EternityFOR/Self_Balance_Car/Self_Balance_Car_PCB_BOM.xlsx

Manufacturer Part | Comment | Footprint | Tolerance | Voltage Rated | Voltage Rating (Max) | Contact Material | Temperature Coefficient | Designator | Device | Name
2.54-1*4P母 | 2.54-1*4P母 | HDR-TH_4P-P2.54-V-F |  |  |  |  |  | H3,H4 | HDR-F_2.54_1x4P
0603WAF0000T5E | 0Ω | R0603 | ±1% |  |  |  | ±100ppm/℃ | R10,R14,R15,R32,R33 | 0603WAF0000T5E | 0Ω
0603WAF1001T5E | 1kΩ | R0603 | ±1% |  |  |  | ±100ppm/℃ | R8 | 0603WAF1001T5E | 1kΩ
0603WAF1002T5E | 10kΩ | R0603 | ±1% |  |  |  | ±100ppm/℃ | R3,R9,R11,R12,R13,R21,R22,R23,R24,R25,R26,R27,R28 | 0603WAF1002T5E | 10kΩ
0603WAF1003T5E | 100kΩ | R0603 | ±1% |  |  |  | ±100ppm/℃ | R4,R5 | 0603WAF1003T5E | 100kΩ
0603WAF1004T5E | 1MΩ | R0603 | ±1% |  |  |  | ±100ppm/℃ | R1 | 0603WAF1004T5E | 1MΩ
0603WAF3300T5E | 330Ω | R0603 | ±1% |  |  |  | ±100ppm/℃ | R19,R20 | 0603WAF3300T5E | 330Ω
0603WAF4700T5E | 470Ω | R0603 | ±1% |  |  |  | ±100ppm/℃ | R18 | 0603WAF4700T5E | 470Ω
0603WAF4701T5E | 4.7kΩ | R0603 | ±1% |  |  |  | ±100ppm/℃ | R29,R30,R31 | 0603WAF1002T5E | 4.7kΩ
0603WAF5100T5E | 510Ω | R0603 | ±1% |  |  |  | ±100ppm/℃ | R2 | 0603WAF5100T5E | 510Ω
AIC1221-33GY3TR | AIC1221-33GY3TR | SOT-223_L6.5-W3.5-P2.30-LS7.0-BR |  |  |  |  |  | U6 | AIC1221-33GY3TR | AIC1221-33GY3TR
CL10A105KB8NNNC | 1uF | C0603 | ±10% | 50V |  |  | X5R | C9,C11,C14 | CL10A105KB8NNNC | 1uF
CL10A106KP8NNNC | 10uF | C0603 | ±10% | 10V |  |  | X5R | C10,C12,C17 | CL10A106KP8NNNC | 10uF
CL10A225KO8NNNC | 2.2uF | C0603 | ±10% | 16V |  |  | X5R | C22 | CL10A225KO8NNNC | 2.2uF
CL10A475KO8NNNC | 4.7uF | C0603 | ±10% | 16V |  |  | X5R | C18,C19 | CL10A475KO8NNNC | 4.7uF
CL10B103KB8NNNC | 10nF | C0603 | ±10% | 50V |  |  | X7R | C27 | 0603B103K500NT | 10nF
CL10B104KB8NNNC | 100nF | C0603 | ±10% | 50V |  |  | X7R | C5,C6,C7,C8,C13,C15,C16,C20,C21,C23,C24,C25,C26,C28,C29 | CL10B104KB8NNNC | 100nF
CL10B222KB8NNNC | 2.2nF | C0603 | ±10% | 50V |  |  | X7R | C30 | 0603B222K500NT | 2.2nF
CL10C200JB8NNNC | 20pF | C0603 | ±5% | 50V |  |  | C0G | C1,C2,C3,C4 | CL10C200JB8NNNC | 20pF
CP2102N-A02-GQFN28R | CP2102N-A02-GQFN28R | QFN-28_L5.0-W5.0-P0.50-TL-EP3.3 |  |  |  |  |  | U5 | CP2102N-A02-GQFN28R | CP2102N-A02-GQFN28R
DS1023-2*3SF11 | DS1023-2*3SF11 | HDR-TH_6P-P2.54-V-F-R2-C3-S2.54 |  |  |  | - |  | H5 | DS1023-2*3SF11 | DS1023-2*3SF11
ESP32-S3-WROOM-1-N8R8 | ESP32-S3-WROOM-1-N8R8 | WIRELM-SMD_ESP32-S3-WROOM-1 |  |  |  |  |  | U9 | ESP32-S3-WROOM-1-N8R8 | ESP32-S3-WROOM-1-N8R8
HC-ZH1.5-6A | HC-ZH1.5-6A | CONN-TH_HC-ZH1.5-6A |  |  |  | 黄铜 |  | CN1,CN2,CN3,CN4 | HC-ZH1.5-6A | HC-ZH1.5-6A
KT-0603B | KT-0603B | LED0603-RD |  |  |  |  |  | LED1,LED4 | KT-0603B | KT-0603B
KT-0603R | KT-0603R | LED0603-RD |  |  |  |  |  | LED2,LED3 | KT-0603R | KT-0603R
L8050QLT1G | L8050QLT1G | SOT-23-3_L2.9-W1.3-P1.90-LS2.4-BR |  |  |  |  |  | Q1,Q2 | L8050QLT1G | L8050QLT1G
L9110S | L9110S | SOP-8_L6.1-W3.9-P1.27-LS6.0-BL-1 |  |  |  |  |  | U1,U2,U3,U4 | L9110S_C725793 | L9110S
LESD5D5.0CT1G | LESD5D5.0CT1G | SOD-523_L1.2-W0.8-LS1.6-BI |  |  |  |  |  | D2,D3,D4 | LESD5D5.0CT1G | LESD5D5.0CT1G
MPU-6050 | MPU-6050 | QFN-24_L4.0-W4.0-P0.50-BL-EP2.7 |  |  |  |  |  | U7 | MPU-6050 | MPU-6050
MTP125-1105S1 | MTP125-1105S1 | HDR-TH_5P-P2.54-V-M |  |  | 1kV | 黄铜 |  | H1,H6,H7,H8 | HDR-M_2.54_1x5P
Q13FC13500004 | 32.768kHz | FC-135R_L3.2-W1.5 |  |  |  |  |  | X1 | Q13FC13500004_C32346 | 32.768kHz
RTT032212FTP | 22.1kΩ | R0603 | ±1% |  |  |  | ±100ppm/℃ | R6 | RTT032212FTP | 22.1kΩ
RTT034752FTP | 47.5kΩ | R0603 | ±1% |  |  |  | ±100ppm/℃ | R7 | RTT034752FTP | 47.5kΩ
SS54 | SS54 | SMA_L4.4-W2.8-LS5.4-R-RD |  |  |  |  |  | D1 | SS54_C22452 | SS54
STM32F103RET6 | STM32F103RET6 | LQFP-64_L10.0-W10.0-P0.50-LS12.0-BL |  |  |  |  |  | U8 | STM32F103RET6 | STM32F103RET6
U262-161N-4BVC11 | U262-161N-4BVC11 | USB-3.1-SMD_U262-161N-4BVC11 |  |  |  | 铜合金 |  | USB1 | U262-161N-4BVC11 | U262-161N-4BVC11
X50328MSB2GI | 8MHz | CRYSTAL-SMD_L5.0-W3.2 |  |  |  |  |  | X2 | X50328MSB2GI | 8MHz
ZX-PZ2.54-2-3PZZ | ZX-PZ2.54-2-3PZZ | HDR-TH_6P-P2.54-V-M-R2-C3-S2.54-1 |  |  | 1kV | 黄铜 |  | H2 | ZX-PZ2.54-2-3PZZ | ZX-PZ2.54-2-3PZZ
ZX-QC34-2TPDZ | ZX-QC34-2TPDZ | KEY-SMD_L3.9-W3.0-LS5.0-EH |  |  |  |  |  | BOOT,RST1,RST2 | ZX-QC34-2TPDZ | ZX-QC34-2TPDZ
