EternityFOR/Self_Balance_Car/Self_Balance_Car_3D_Model/Bottom_Mount.SLDPRT

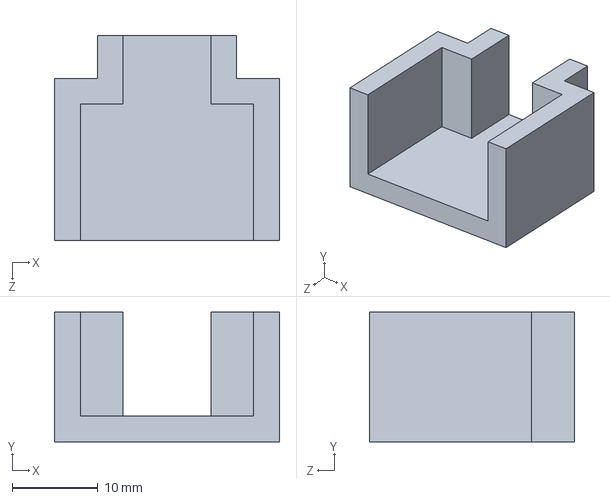
[picture p9: CAD file, 2024-07-28]
Self_Balance_Car_3D_Model/Bottom_Mount.SLDPRT
26.2 x 15.1 x 23.9 mm
