EternityFOR/Self_Balance_Car/Self_Balance_Car_3D_Model/Print/Wheel_NEW2.3mf

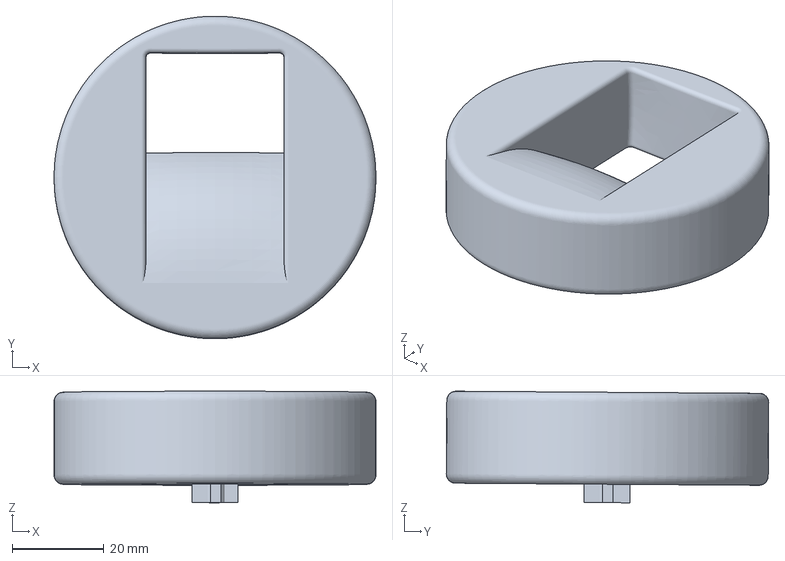
[picture p10: CAD file, 2024-07-28]
Self_Balance_Car_3D_Model/Print/Wheel_NEW2.3mf
70.0 x 70.1 x 24.3 mm
