EternityFOR/Self_Balance_Car/Self_Balance_Car_3D_Model/Body.SLDPRT

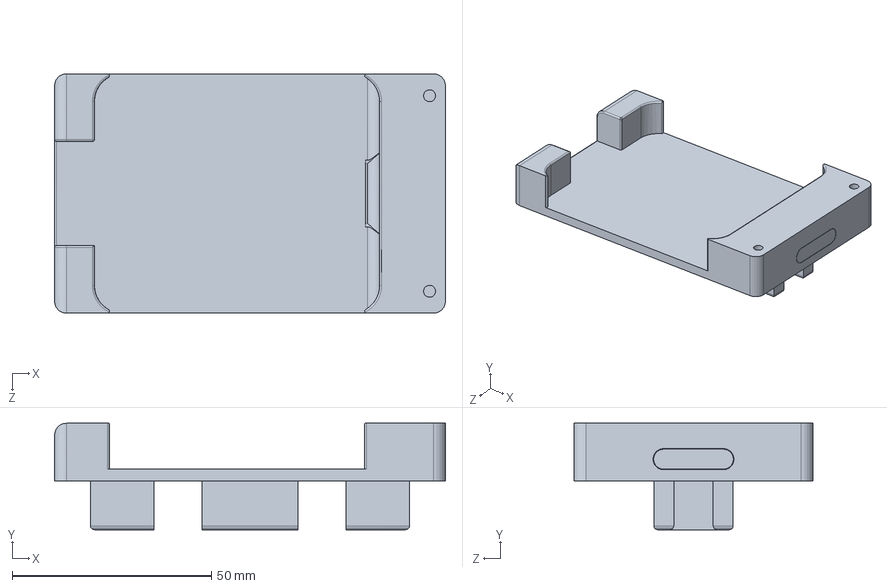
[picture p11: CAD file, 2024-07-23]
Self_Balance_Car_3D_Model/Body.SLDPRT
98.0 x 26.7 x 60.0 mm
