EternityFOR/Self_Balance_Car/Self_Balance_Car_3D_Model/Motor_mount2.SLDPRT

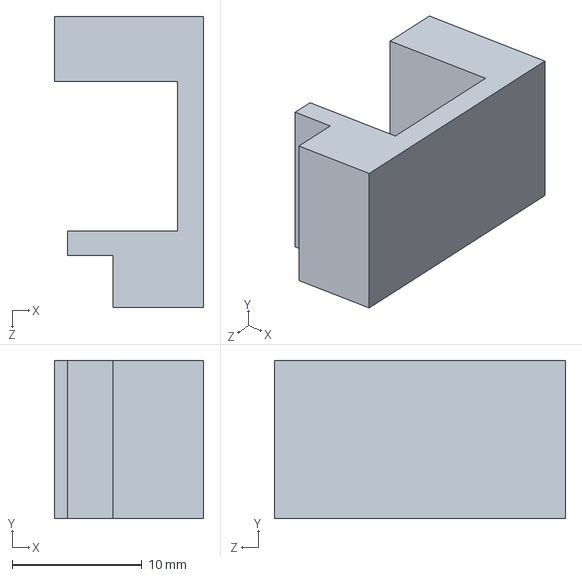
[picture p12: CAD file, 2024-07-19]
Self_Balance_Car_3D_Model/Motor_mount2.SLDPRT
11.5 x 12.2 x 22.4 mm
