EternityFOR/Self_Balance_Car/Self_Balance_Car_3D_Model/Print/WheelR.STL

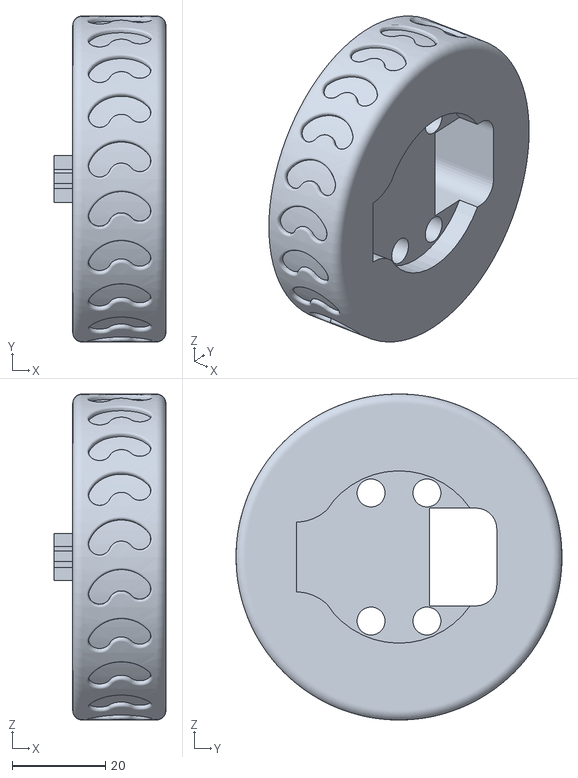
[picture p13: CAD file, 2024-07-19]
Self_Balance_Car_3D_Model/Print/WheelR.STL
24.0 x 70.0 x 70.0
