EternityFOR/Self_Balance_Car/Self_Balance_Car_3D_Model/Motor_Axle.SLDPRT

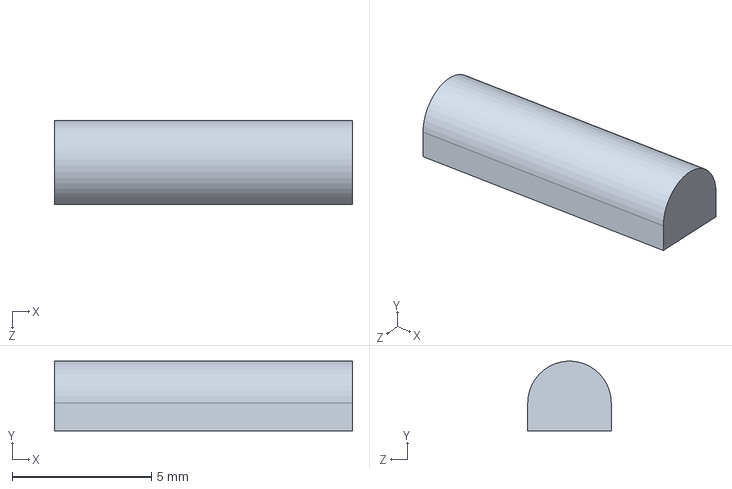
[picture p14: CAD file, 2024-07-19]
Self_Balance_Car_3D_Model/Motor_Axle.SLDPRT
10.7 x 2.50 x 3.00 mm
