EternityFOR/Self_Balance_Car/Self_Balance_Car_3D_Model/Print/Wheel_Big_New.STL

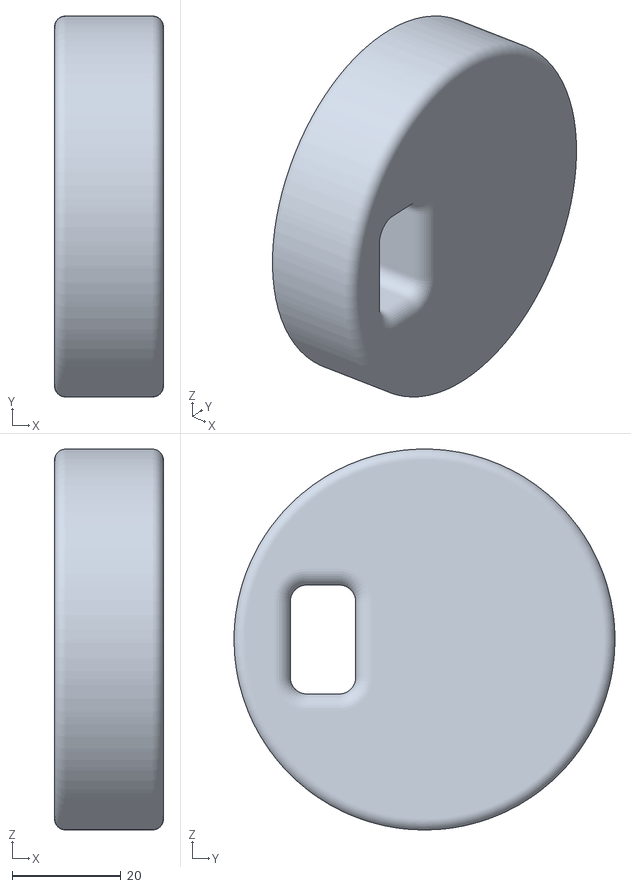
[picture p15: CAD file, 2024-07-19]
Self_Balance_Car_3D_Model/Print/Wheel_Big_New.STL
20.0 x 70.0 x 70.0
