EternityFOR/Self_Balance_Car/Self_Balance_Car_3D_Model/Motor.SLDPRT

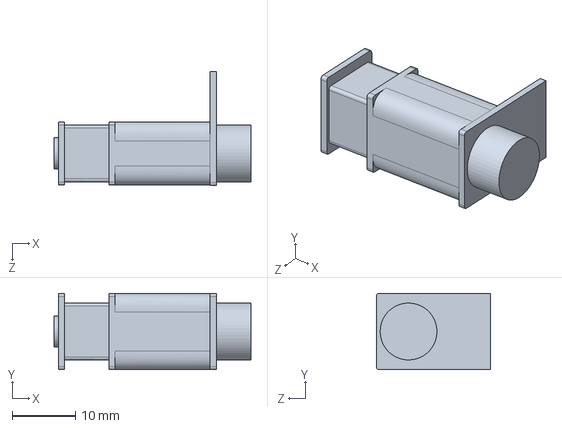
[picture p16: CAD file, 2024-07-19]
Self_Balance_Car_3D_Model/Motor.SLDPRT
31.2 x 12.1 x 18.1 mm
