EternityFOR/Self_Balance_Car/Self_Balance_Car_3D_Model/Print/Small.3mf

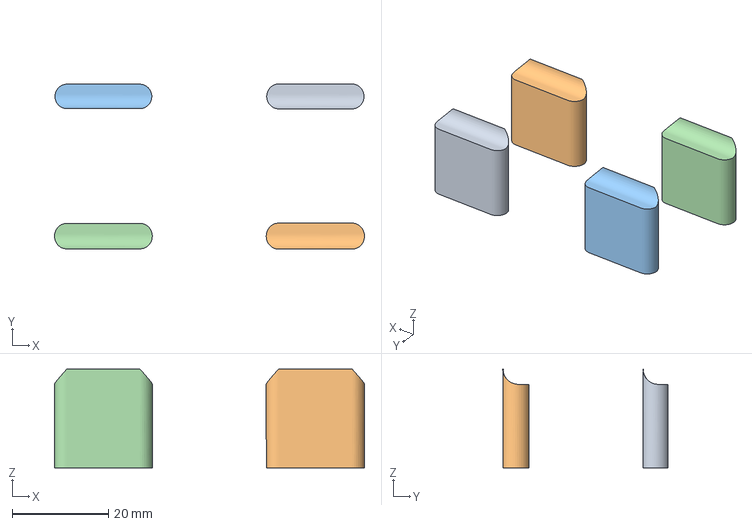
[picture p17: CAD file, 2024-07-19]
Self_Balance_Car_3D_Model/Print/Small.3mf
64.3 x 34.3 x 20.5 mm
Small.STL x 4
