EternityFOR/Self_Balance_Car/Self_Balance_Car_3D_Model/Power_Bank.SLDPRT

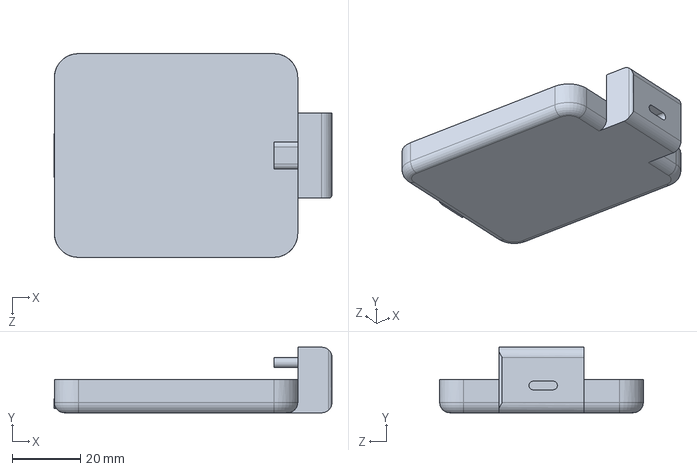
[picture p18: CAD file, 2024-07-19]
Self_Balance_Car_3D_Model/Power_Bank.SLDPRT
81.3 x 19.2 x 59.6 mm
