EternityFOR/Self_Balance_Car/Self_Balance_Car_3D_Model/Print/Middle_plate_up.STL

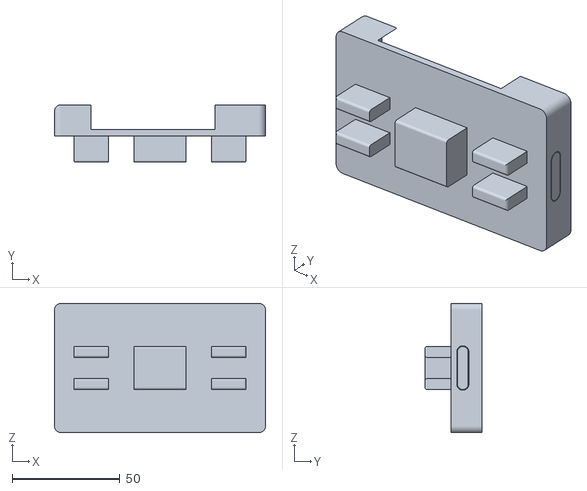
[picture p19: CAD file, 2024-07-19]
Self_Balance_Car_3D_Model/Print/Middle_plate_up.STL
98.0 x 26.7 x 60.0
