EternityFOR/Self_Balance_Car/Self_Balance_Car_3D_Model/Print/Right_Wheel_big.STL

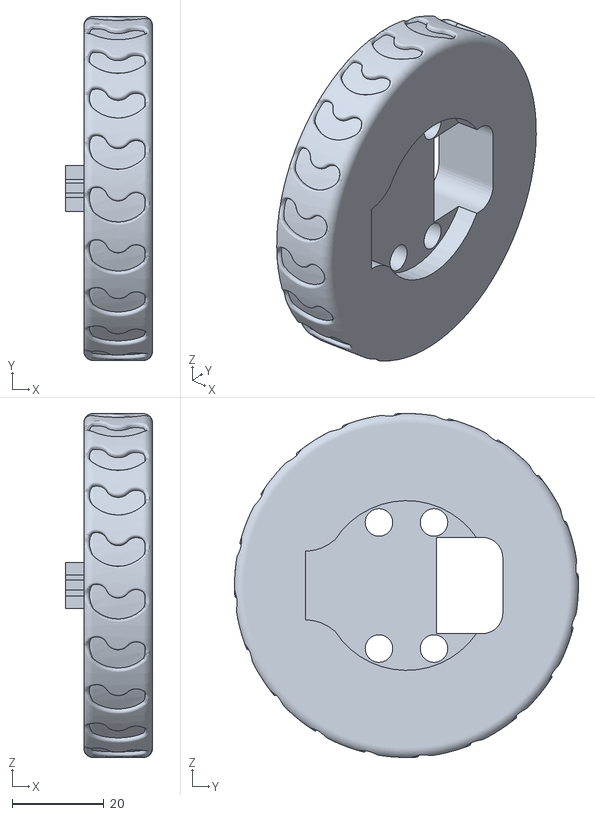
[picture p20: CAD file, 2024-07-19]
Self_Balance_Car_3D_Model/Print/Right_Wheel_big.STL
19.0 x 75.0 x 75.0
