EternityFOR/Self_Balance_Car/Self_Balance_Car_3D_Model/Print/Top_Cover.STL

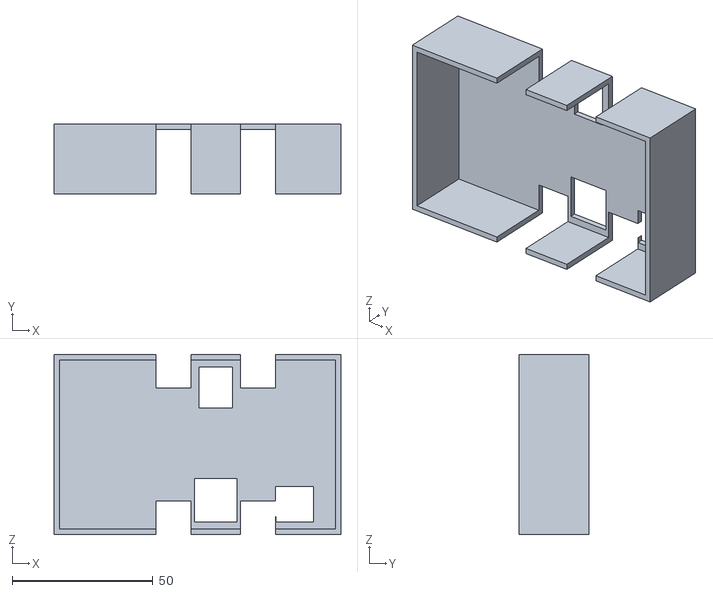
[picture p21: CAD file, 2024-07-19]
Self_Balance_Car_3D_Model/Print/Top_Cover.STL
102.0 x 25.0 x 64.0
