EternityFOR/Self_Balance_Car/Self_Balance_Car_3D_Model/Print/Bottom_Mount^Assem1.STL

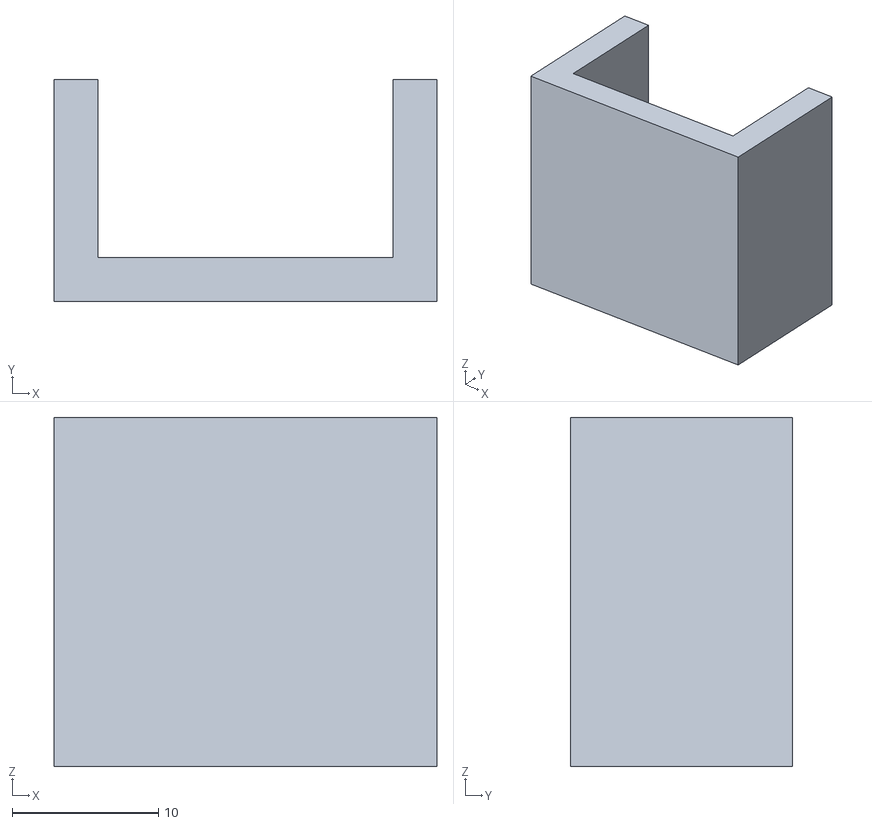
[picture p22: CAD file, 2024-07-19]
Self_Balance_Car_3D_Model/Print/Bottom_Mount^Assem1.STL
26.2 x 15.2 x 23.9
