EternityFOR/Self_Balance_Car/(list of files, cad)

Other CAD files:
Self_Balance_Car_3D_Model/Print/Wheel_NEW1.3mf
Self_Balance_Car_3D_Model/Print/Right_NEW.STL
Self_Balance_Car_3D_Model/Wheel.SLDPRT
Self_Balance_Car_3D_Model/Print/Left_NEW.STL
Self_Balance_Car_3D_Model/Middle_body.SLDPRT
Self_Balance_Car_3D_Model/Print/Wheel_Big_New2.STL
Self_Balance_Car_3D_Model/Print/WheelL.STL
Self_Balance_Car_3D_Model/Print/Left_Wheel_big.STL
Self_Balance_Car_3D_Model/Print/Body.3mf
Self_Balance_Car_3D_Model/Print/Body.STL
Self_Balance_Car_3D_Model/Print/Bottom_Mount.STL
Self_Balance_Car_3D_Model/Print/Motor_mount2.STL
Self_Balance_Car_3D_Model/Print/Small.STL
Self_Balance_Car_3D_Model/Print/Wheel_NEW1.STL
Self_Balance_Car_3D_Model/backup/Bread_Board.SLDPRT
Self_Balance_Car_3D_Model/backup/Middle_body.SLDPRT
Self_Balance_Car_3D_Model/backup/Middle_bread_board_down.SLDPRT
Self_Balance_Car_3D_Model/backup/Motor_backup.SLDPRT
Self_Balance_Car_3D_Model/backup/Motor_mount.SLDPRT
Self_Balance_Car_3D_Model/backup/Motor_mount2(1).SLDPRT
Self_Balance_Car_3D_Model/backup/Right_Wheel.SLDPRT
Self_Balance_Car_3D_Model/backup/Right_Wheel_big.SLDPRT
Self_Balance_Car_3D_Model/backup/Speaker.SLDPRT
Self_Balance_Car_3D_Model/backup/Wheel.SLDPRT
