EternityFOR/Self_Balance_Car/Self_Balance_Car_STM32F103RET6/Core/Src/main.c

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
/* Includes ------------------------------------------------------------------*/
#include "main.h"
#include "cmsis_os.h"

/* USER CODE BEGIN Includes */
#include <stdio.h>
#include <string.h>
#include <math.h>
#include "stm32f1xx_hal_flash.h"
//Gyro
#include "Gyro.h"
//Motor
#include "Motor.h"
//Encoder
#include "Encoder.h"

/* USER CODE END Includes */

DAC_HandleTypeDef hdac;

I2C_HandleTypeDef hi2c1;
I2C_HandleTypeDef hi2c2;

SPI_HandleTypeDef hspi2;

TIM_HandleTypeDef htim1;
TIM_HandleTypeDef htim2;
TIM_HandleTypeDef htim3;
TIM_HandleTypeDef htim4;
TIM_HandleTypeDef htim5;
TIM_HandleTypeDef htim8;

UART_HandleTypeDef huart2;
DMA_HandleTypeDef hdma_usart2_rx;
DMA_HandleTypeDef hdma_usart2_tx;

/* Definitions for msg_rx_t */
osThreadId_t msg_rx_tHandle;
const osThreadAttr_t msg_rx_t_attributes = {
  .name = "msg_rx_t",
  .stack_size = 512 * 4,
  .priority = (osPriority_t) osPriorityNormal,
};
/* Definitions for Motor_update_t */
osThreadId_t Motor_update_tHandle;
const osThreadAttr_t Motor_update_t_attributes = {
  .name = "Motor_update_t",
  .stack_size = 128 * 4,
  .priority = (osPriority_t) osPriorityNormal,
};
/* Definitions for msg_rx_q */
osMessageQueueId_t msg_rx_qHandle;
const osMessageQueueAttr_t msg_rx_q_attributes = {
  .name = "msg_rx_q"
};
/* USER CODE BEGIN PV */
//Car_ctr&setup_data
#define FLASH_PID_PARAMS_ADDRESS 0x0800ff00
#define RX_BUFFER_SIZE_1 150
uint8_t rxBuffer_1[RX_BUFFER_SIZE_1];
uint8_t rxIndex_1 = 0;
uint8_t rxData_1;
//#define RX_BUFFER_SIZE_2 64
//uint8_t rxBuffer_2[RX_BUFFER_SIZE_2];
//uint8_t rxIndex_2 = 0;
//uint8_t rxData_2;
typedef enum {
    DataType_Control,
    DataType_Weather,
    DataType_PID,
    DataType_Mode_Control,
    DataType_Unknown // Useful for error handling
} DataType;
typedef struct {
    DataType type;
    uint8_t msg_Data[RX_BUFFER_SIZE_1];
    int L; // Left wheel speed
    int R; // Right wheel speed
    int A; // Additional action or mode

    struct {
        float Balance_Kp, Balance_Ki, Balance_Kd; // Balance PID
        float Velocity_Kp, Velocity_Ki, Velocity_Kd; // Velocity PID
    } PID;

    struct {
        char weather[32]; // Description of the weather
        int temperature; // Temperature
        char date[16]; // Date in YYYY-MM-DD format
        char time[16]; // Time HH:MM format
    } WeatherData;
} msg_data_t;
MotorControl motor_R, motor_L;
float Balance_Kp, Balance_Ki, Balance_Kd;
float Velocity_Kp, Velocity_Ki, Velocity_Kd;
#define DEFAULT_BALANCE_KP 263.0f
#define DEFAULT_BALANCE_KI 0.0f
#define DEFAULT_BALANCE_KD 0.4f
#define DEFAULT_VELOCITY_KP 0.6f
#define DEFAULT_VELOCITY_KI 0.0025f
#define DEFAULT_VELOCITY_KD 0.0f
uint8_t ctr_cmd;
/* USER CODE END PV */

void SystemClock_Config(void);
static void MX_GPIO_Init(void);
static void MX_DMA_Init(void);
static void MX_TIM1_Init(void);
static void MX_TIM2_Init(void);
static void MX_TIM3_Init(void);
static void MX_TIM4_Init(void);
static void MX_TIM8_Init(void);
static void MX_I2C2_Init(void);
static void MX_TIM5_Init(void);
static void MX_USART2_UART_Init(void);
static void MX_DAC_Init(void);
static void MX_I2C1_Init(void);
static void MX_SPI2_Init(void);
void msg_rx(void *argument);
void Motor_update(void *argument);

/* USER CODE BEGIN PFP */
int _write(int file , char *ptr,int len)
{
    int i = 0;
    for(i = 0;i<len;i++)
        ITM_SendChar((*ptr++));
    return len;
}
/* USER CODE END PFP */

/* USER CODE BEGIN 0 */
void Timer_Start(void)
{
// ***** CN2 CN4 *****
	HAL_TIM_PWM_Start(&htim1, TIM_CHANNEL_1);
	HAL_TIM_PWM_Start(&htim1, TIM_CHANNEL_2);
	HAL_TIM_PWM_Start(&htim8, TIM_CHANNEL_1);
	HAL_TIM_PWM_Start(&htim8, TIM_CHANNEL_2);
	HAL_TIM_Encoder_Start(&htim3, TIM_CHANNEL_1);
	HAL_TIM_Encoder_Start(&htim3, TIM_CHANNEL_2);
	HAL_TIM_Encoder_Start(&htim5, TIM_CHANNEL_1);
	HAL_TIM_Encoder_Start(&htim5, TIM_CHANNEL_2);

// ***** CN1 CN3 *****
//	  HAL_TIM_PWM_Start(&htim1, TIM_CHANNEL_3);
//	  HAL_TIM_PWM_Start(&htim1, TIM_CHANNEL_4);
//	  HAL_TIM_PWM_Start(&htim8, TIM_CHANNEL_3);
//	  HAL_TIM_PWM_Start(&htim8, TIM_CHANNEL_4);
//	  HAL_TIM_Encoder_Start(&htim2, TIM_CHANNEL_1);
//	  HAL_TIM_Encoder_Start(&htim2, TIM_CHANNEL_2);
//	  HAL_TIM_Encoder_Start(&htim4, TIM_CHANNEL_1);
//	  HAL_TIM_Encoder_Start(&htim4, TIM_CHANNEL_2);
}
int is_nan(float value) {
    // Check standard isnan
    if (isnan(value)) return 1;

    // Additional check for NaN representation using union
    union {
        float f;
        uint32_t u;
    } converter;

    converter.f = value;
    return (converter.u & 0x7fffffff) > 0x7f800000;
}
/* USER CODE END 0 */

/**
  * @brief  The application entry point.
  * @retval int
  */
int main(void)
{

  /* MCU Configuration--------------------------------------------------------*/

  /* Reset of all peripherals, Initializes the Flash interface and the Systick. */
  HAL_Init();

  /* Configure the system clock */
  SystemClock_Config();

  /* Initialize all configured peripherals */
  MX_GPIO_Init();
  MX_DMA_Init();
  MX_TIM1_Init();
  MX_TIM2_Init();
  MX_TIM3_Init();
  MX_TIM4_Init();
  MX_TIM8_Init();
  MX_I2C2_Init();
  MX_TIM5_Init();
  MX_USART2_UART_Init();
  MX_DAC_Init();
  MX_I2C1_Init();
  MX_SPI2_Init();
  /* USER CODE BEGIN 2 */
  BSP_MPU6050_Init();
  Timer_Start();
  ReadPIDParamsFromFlash(&Balance_Kp, &Balance_Ki, &Balance_Kd, &Velocity_Kp, &Velocity_Ki, &Velocity_Kd);

// ***** CN2 CN4 *****
  initMotorControl(&motor_R, TIM_CHANNEL_1, TIM_CHANNEL_2, GetEncoder_Counter_R);
  initMotorControl(&motor_L, TIM_CHANNEL_1, TIM_CHANNEL_2, GetEncoder_Counter_L);

// ***** CN1 CN3 *****
//  initMotorControl(&motor_R, TIM_CHANNEL_3, TIM_CHANNEL_4, GetEncoder_Counter_R);
//  initMotorControl(&motor_L, TIM_CHANNEL_3, TIM_CHANNEL_4, GetEncoder_Counter_L);
  /* USER CODE END 2 */

  /* Init scheduler */
  osKernelInitialize();

  /* USER CODE BEGIN RTOS_MUTEX */
  /* add mutexes, ... */
  /* USER CODE END RTOS_MUTEX */

  /* USER CODE BEGIN RTOS_SEMAPHORES */
  /* add semaphores, ... */
  /* USER CODE END RTOS_SEMAPHORES */

  /* USER CODE BEGIN RTOS_TIMERS */
  /* start timers, add new ones, ... */
  /* USER CODE END RTOS_TIMERS */

  /* Create the queue(s) */
  /* creation of msg_rx_q */
  msg_rx_qHandle = osMessageQueueNew (10, sizeof(msg_data_t), &msg_rx_q_attributes);

  /* USER CODE BEGIN RTOS_QUEUES */
  /* add queues, ... */
  /* USER CODE END RTOS_QUEUES */

  /* Create the thread(s) */
  /* creation of msg_rx_t */
  msg_rx_tHandle = osThreadNew(msg_rx, NULL, &msg_rx_t_attributes);

  /* creation of Motor_update_t */
  Motor_update_tHandle = osThreadNew(Motor_update, NULL, &Motor_update_t_attributes);

  /* USER CODE BEGIN RTOS_THREADS */
  /* add threads, ... */
  /* USER CODE END RTOS_THREADS */

  /* USER CODE BEGIN RTOS_EVENTS */
  /* add events, ... */
  /* USER CODE END RTOS_EVENTS */

  /* Start scheduler */
  osKernelStart();

  /* We should never get here as control is now taken by the scheduler */

  /* Infinite loop */
  /* USER CODE BEGIN WHILE */

  while (1)
  {
    /* USER CODE END WHILE */

    /* USER CODE BEGIN 3 */
  }
  /* USER CODE END 3 */
}

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
/* USER CODE BEGIN 4 */
//Uart Callback

HAL_StatusTypeDef WritePIDParamsToFlash(float Balance_Kp, float Balance_Ki, float Balance_Kd, float Velocity_Kp, float Velocity_Ki, float Velocity_Kd) {
    HAL_StatusTypeDef status;
    uint32_t data[6];
    uint32_t address = FLASH_PID_PARAMS_ADDRESS;

    memcpy(&data[0], &Balance_Kp, sizeof(float));
    memcpy(&data[1], &Balance_Ki, sizeof(float));
    memcpy(&data[2], &Balance_Kd, sizeof(float));
    memcpy(&data[3], &Velocity_Kp, sizeof(float));
    memcpy(&data[4], &Velocity_Ki, sizeof(float));
    memcpy(&data[5], &Velocity_Kd, sizeof(float));

    //FLASH_Unlock
    HAL_FLASH_Unlock();

    FLASH_EraseInitTypeDef eraseInitStruct;
    uint32_t SectorError;
    eraseInitStruct.TypeErase = FLASH_TYPEERASE_PAGES;
    eraseInitStruct.PageAddress = FLASH_PID_PARAMS_ADDRESS;
    eraseInitStruct.NbPages = 1;
    status = HAL_FLASHEx_Erase(&eraseInitStruct, &SectorError);
    if (status != HAL_OK) {
        HAL_FLASH_Lock();
        return status;
    }

    /* Write the PID parameters to flash, word by word (32 bits) */
    for (uint32_t i = 0; i < (sizeof(data) / sizeof(uint32_t)); i++) {
        status = HAL_FLASH_Program(FLASH_TYPEPROGRAM_WORD, address, data[i]);
        if (status != HAL_OK) {
            break;
        }
        address += 4;
    }
    //FLASH_Lock
    HAL_FLASH_Lock();

    return status;
}

void ReadPIDParamsFromFlash(float *Balance_Kp, float *Balance_Ki, float *Balance_Kd, float *Velocity_Kp, float *Velocity_Ki, float *Velocity_Kd) {
    memcpy(Balance_Kp, (float*)FLASH_PID_PARAMS_ADDRESS, sizeof(float));
    memcpy(Balance_Ki, (float*)(FLASH_PID_PARAMS_ADDRESS + 4), sizeof(float));
    memcpy(Balance_Kd, (float*)(FLASH_PID_PARAMS_ADDRESS + 8), sizeof(float));
    memcpy(Velocity_Kp, (float*)(FLASH_PID_PARAMS_ADDRESS + 12), sizeof(float));
    memcpy(Velocity_Ki, (float*)(FLASH_PID_PARAMS_ADDRESS + 16), sizeof(float));
    memcpy(Velocity_Kd, (float*)(FLASH_PID_PARAMS_ADDRESS + 20), sizeof(float));

    // Check for NaN values and set to default if necessary
    if (is_nan(*Balance_Kp)) *Balance_Kp = DEFAULT_BALANCE_KP;
    if (is_nan(*Balance_Ki)) *Balance_Ki = DEFAULT_BALANCE_KI;
    if (is_nan(*Balance_Kd)) *Balance_Kd = DEFAULT_BALANCE_KD;
    if (is_nan(*Velocity_Kp)) *Velocity_Kp = DEFAULT_VELOCITY_KP;
    if (is_nan(*Velocity_Ki)) *Velocity_Ki = DEFAULT_VELOCITY_KI;
    if (is_nan(*Velocity_Kd)) *Velocity_Kd = DEFAULT_VELOCITY_KD;
}

void UART_IRQHandler_IDLE(UART_HandleTypeDef *huart)
{
	msg_data_t ctr;
	if(huart == &huart2)
	{
		if(__HAL_UART_GET_FLAG(huart, UART_FLAG_IDLE) != RESET)
		{
			HAL_UART_DMAStop(&huart2);
			__HAL_UART_CLEAR_IDLEFLAG(&huart2);
			__HAL_UART_CLEAR_OREFLAG(&huart2);
			memcpy(ctr.msg_Data ,rxBuffer_1, sizeof(rxBuffer_1));
			osStatus_t status = osMessageQueuePut(msg_rx_qHandle, &ctr, 0, 0);
			if (status != osOK) {printf("Failed to put message into queue\n");}
			HAL_UART_Receive_DMA(&huart2, rxBuffer_1, sizeof(rxBuffer_1));
		}
	}
}

/* USER CODE END 4 */

/* USER CODE BEGIN Header_msg_rx */
/**
  * @brief  Function implementing the msg_rx_t thread.
  * @param  argument: Not used
  * @retval None
  */
/* USER CODE END Header_msg_rx */
void msg_rx(void *argument)
{
  /* USER CODE BEGIN 5 */
	msg_data_t ctr;
	char type[32];
	for(;;) {
		if (osMessageQueueGet(msg_rx_qHandle, &ctr, NULL, osWaitForever) == osOK) {
			printf("%s\n",ctr.msg_Data);
			if (sscanf((char*)ctr.msg_Data, "{\"Type\":\"%[^\"]\"", type) == 1) {
				if (strcmp(type, "Control") == 0) {
					if (sscanf((char*)ctr.msg_Data, "{\"Type\":\"Control\",\"L\":%d,\"R\":%d,\"A\":%d}",
							   &ctr.L, &ctr.R, &ctr.A) == 3) {
						motor_R.targetSpeed = ctr.R;
						motor_L.targetSpeed = ctr.L;
						ctr_cmd = ctr.A;
						ctr.type = DataType_Control;
					}
				}
				else if (strcmp(type, "Weather") == 0) {
					if (sscanf((char*)ctr.msg_Data, "{\"Type\":\"Weather\",\"Weather\":\"%[^\"]\",\"Temperature\":%d,\"Date\":\"%[^\"]\",\"Time\":\"%[^\"]\"}",
							   ctr.WeatherData.weather,
							   &ctr.WeatherData.temperature,
							   ctr.WeatherData.date,
							   ctr.WeatherData.time) == 4) {
						printf("Weather: %s, Temp: %d, Date: %s, Time: %s\n",
							   ctr.WeatherData.weather,
							   ctr.WeatherData.temperature,
							   ctr.WeatherData.date,
							   ctr.WeatherData.time);
						ctr.type = DataType_Weather;
					}
				} else if (strcmp(type, "PID") == 0) {
					if (sscanf((char*)ctr.msg_Data, "{\"Type\":\"PID\",\"Balance_Kp\":%f,\"Balance_Ki\":%f,\"Balance_Kd\":%f,\"Velocity_Kp\":%f,\"Velocity_Ki\":%f,\"Velocity_Kd\":%f}",
							   &ctr.PID.Balance_Kp,
							   &ctr.PID.Balance_Ki,
							   &ctr.PID.Balance_Kd,
							   &ctr.PID.Velocity_Kp,
							   &ctr.PID.Velocity_Ki,
							   &ctr.PID.Velocity_Kd) == 6) {
						Balance_Kp = ctr.PID.Balance_Kp;
						Balance_Ki = ctr.PID.Balance_Ki;
						Balance_Kd = ctr.PID.Balance_Kd;
						Velocity_Kp = ctr.PID.Velocity_Kp;
						Velocity_Ki = ctr.PID.Velocity_Ki;
						Velocity_Kd = ctr.PID.Velocity_Kd;
						ctr.type = DataType_PID;
						if (WritePIDParamsToFlash(Balance_Kp, Balance_Ki, Balance_Kd, Velocity_Kp, Velocity_Ki, Velocity_Kd) != HAL_OK) {
							printf("PID_store_to_flash_failed\n");
						}
					}
				}
				else if (strcmp(type, "Mode_Control") == 0) {
					printf("Mode control switch\n");
					ctr.type = DataType_Mode_Control;
				} else {
					printf("Unknown message type\n");
					ctr.type = DataType_Unknown;
				}
			}
		}
		osDelay(1);
	}
  /* USER CODE END 5 */
}

/* USER CODE BEGIN Header_Motor_update */
/**
* @brief Function implementing the Motor_update_t thread.
* @param argument: Not used
* @retval None
*/
/* USER CODE END Header_Motor_update */
void Motor_update(void *argument)
{
  /* USER CODE BEGIN Motor_update */
	  int count = 1;

	  /* Infinite loop */
	  for(;;)
	  {
		  read_angle(&motor_R, &motor_L);
		  if (count % 10 == 0) {
			Velocity_PID_Control(&motor_R, &motor_L);
		  }

		  Balance_PID_Control(&motor_R, &motor_L);

		  if (HAL_GPIO_ReadPin(GPIOC, Mode_Detection_Pin) == GPIO_PIN_RESET) {
			UpdateMotorPWM(&motor_R, &motor_L);
		  }

		  osDelay(5);
		  count = (count ) % 10 == 0 ? 1: count+1;
	  }
  /* USER CODE END Motor_update */
}

/**
  * @brief  Period elapsed callback in non blocking mode
  * @note   This function is called  when TIM6 interrupt took place, inside
  * HAL_TIM_IRQHandler(). It makes a direct call to HAL_IncTick() to increment
  * a global variable "uwTick" used as application time base.
  * @param  htim : TIM handle
  * @retval None
  */
void HAL_TIM_PeriodElapsedCallback(TIM_HandleTypeDef *htim)
{
  if (htim->Instance == TIM6) {
    HAL_IncTick();
  }
}

/**
  * @brief  This function is executed in case of error occurrence.
  * @retval None
  */
void Error_Handler(void)
{
  /* USER CODE BEGIN Error_Handler_Debug */
  /* User can add his own implementation to report the HAL error return state */
  __disable_irq();
  while (1)
  {
  }
  /* USER CODE END Error_Handler_Debug */
}

#ifdef  USE_FULL_ASSERT
/**
  * @brief  Reports the name of the source file and the source line number
  *         where the assert_param error has occurred.
  * @param  file: pointer to the source file name
  * @param  line: assert_param error line source number
  * @retval None
  */
void assert_failed(uint8_t *file, uint32_t line)
{
  /* USER CODE BEGIN 6 */
  /* User can add his own implementation to report the file name and line number,
     ex: printf("Wrong parameters value: file %s on line %d\r\n", file, line) */
  /* USER CODE END 6 */
}
#endif /* USE_FULL_ASSERT */
