EternityFOR/Self_Balance_Car/Self_Balance_Car_STM32F103RET6/Core/Inc/main.h

#define M2_EN1_Pin GPIO_PIN_0
#define M2_EN1_GPIO_Port GPIOA
#define M2_EN2_Pin GPIO_PIN_1
#define M2_EN2_GPIO_Port GPIOA
#define M2_IB2_Pin GPIO_PIN_6
#define M2_IB2_GPIO_Port GPIOC
#define M2_IA2_Pin GPIO_PIN_7
#define M2_IA2_GPIO_Port GPIOC
#define M3_IB3_Pin GPIO_PIN_8
#define M3_IB3_GPIO_Port GPIOC
#define M3_IA3_Pin GPIO_PIN_9
#define M3_IA3_GPIO_Port GPIOC
#define M4_IA4_Pin GPIO_PIN_8
#define M4_IA4_GPIO_Port GPIOA
#define M4_IB4_Pin GPIO_PIN_9
#define M4_IB4_GPIO_Port GPIOA
#define M1_IA1_Pin GPIO_PIN_10
#define M1_IA1_GPIO_Port GPIOA
#define M1_IB1_Pin GPIO_PIN_11
#define M1_IB1_GPIO_Port GPIOA
#define M3_EN1_Pin GPIO_PIN_15
#define M3_EN1_GPIO_Port GPIOA
#define Running_Mode_Pin GPIO_PIN_10
#define Running_Mode_GPIO_Port GPIOC
#define Mode_Detection_Pin GPIO_PIN_11
#define Mode_Detection_GPIO_Port GPIOC
#define Charging_Mode_Pin GPIO_PIN_12
#define Charging_Mode_GPIO_Port GPIOC
#define M3_EN2_Pin GPIO_PIN_3
#define M3_EN2_GPIO_Port GPIOB
#define M4_EN1_Pin GPIO_PIN_4
#define M4_EN1_GPIO_Port GPIOB
#define M4_EN2_Pin GPIO_PIN_5
#define M4_EN2_GPIO_Port GPIOB
#define M1_EN1_Pin GPIO_PIN_6
#define M1_EN1_GPIO_Port GPIOB
#define M1_EN2_Pin GPIO_PIN_7
#define M1_EN2_GPIO_Port GPIOB
