EternityFOR/Self_Balance_Car/(commit log)

2024-07-19 SCH & PCB UPLOAD
2024-07-19 3D MODEL UPLOAD
    [Body.SLDPRT, Bottom_Mount.SLDPRT, Bottom_Mount.STL, Bottom_Mount^Assem1.STL, Bread_Board.SLDPRT, Left_NEW.STL, Left_Wheel_big.STL, Middle_body.SLDPRT]
2024-07-23 3D MODEL UPDATE
    [Body.SLDPRT, Body.STL]
2024-07-31 1.Schematic and PCB Debug 2.APP_1.0.0:BLUFI Debug
    [Self_Balance_Car_PCB_BOM.xlsx]
2024-08-05 STM32CUBEIDE UPDATE
