EternityFOR/Self_Balance_Car/(notices)

Notices in the files:
Self_Balance_Car_STM32F103RET6/Core/Inc/main.h:
Copyright (c) 2024 STMicroelectronics.
All rights reserved.
This software is licensed under terms that can be found in the LICENSE file
